DonaldB2003/CNC-Homework-Writing-Machine/3d-models/drawing-robot-arduino-uno-cnc-shield-grbl-model_files/y_back.stl

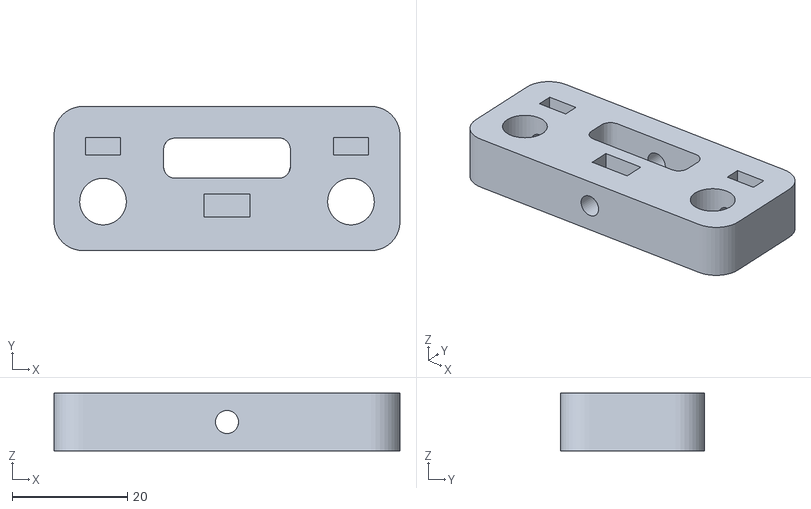
[picture p5: CAD file, 2026-09-09]
3d-models/drawing-robot-arduino-uno-cnc-shield-grbl-model_files/y_back.stl
60.0 x 25.0 x 10.0
