DonaldB2003/CNC-Homework-Writing-Machine/3d-models/drawing-robot-arduino-uno-cnc-shield-grbl-model_files/base_slide_heavy_duty_ha.stl

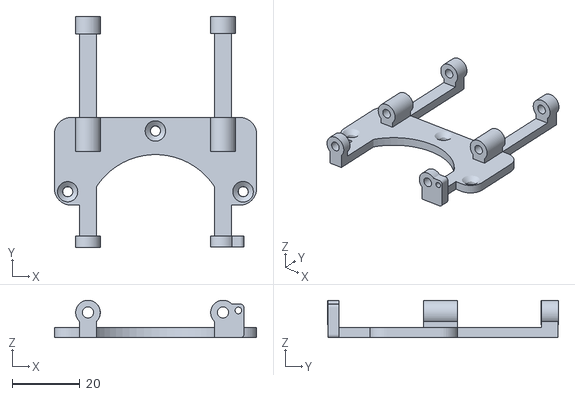
[picture p7: CAD file, 2026-09-09]
3d-models/drawing-robot-arduino-uno-cnc-shield-grbl-model_files/base_slide_heavy_duty_ha.stl
60.0 x 68.5 x 11.1
