DonaldB2003/CNC-Homework-Writing-Machine/3d-models/drawing-robot-arduino-uno-cnc-shield-grbl-model_files/uno_cnc_bottom.stl

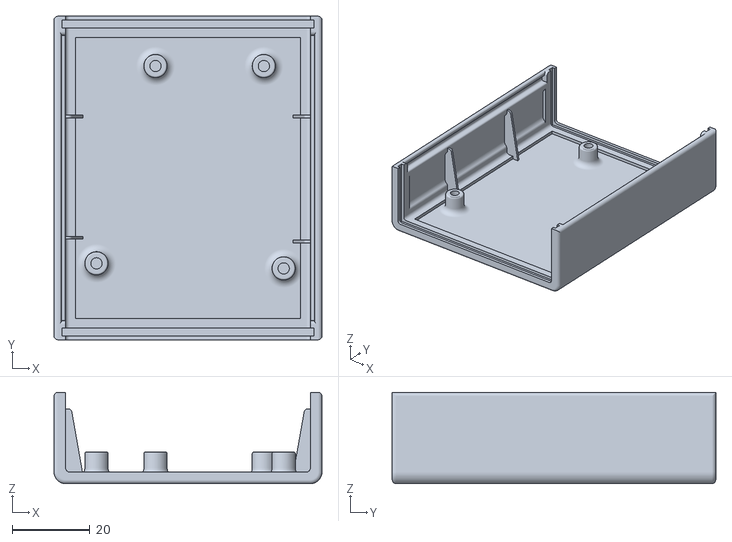
[picture p8: CAD file, 2026-09-09]
3d-models/drawing-robot-arduino-uno-cnc-shield-grbl-model_files/uno_cnc_bottom.stl
69.0 x 83.3 x 23.5
