DonaldB2003/CNC-Homework-Writing-Machine/3d-models/drawing-robot-arduino-uno-cnc-shield-grbl-model_files/cablestrainreliefanchorv2.stl

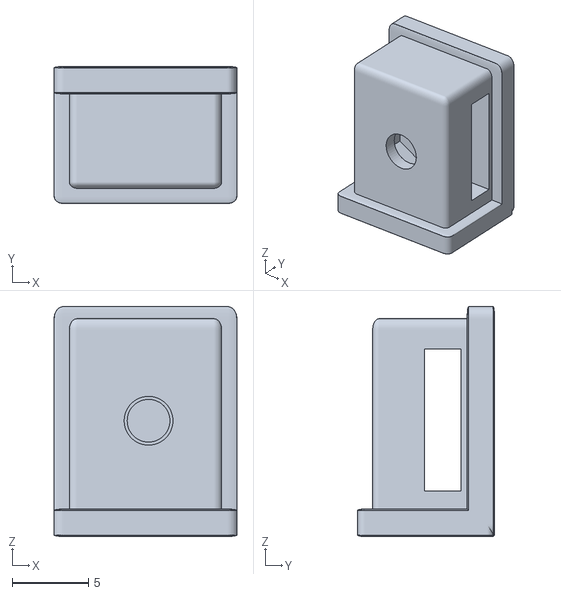
[picture p9: CAD file, 2026-09-09]
3d-models/drawing-robot-arduino-uno-cnc-shield-grbl-model_files/cablestrainreliefanchorv2.stl
12.0 x 9.00 x 15.1
