DonaldB2003/CNC-Homework-Writing-Machine/3d-models/drawing-robot-arduino-uno-cnc-shield-grbl-model_files/bottom_xy_clamshell_v2.stl

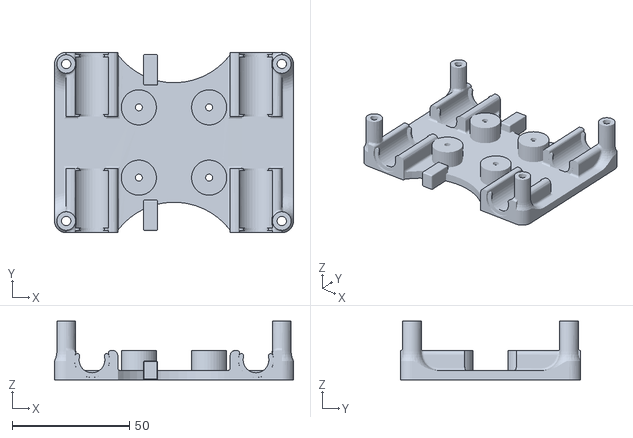
[picture p10: CAD file, 2026-09-09]
3d-models/drawing-robot-arduino-uno-cnc-shield-grbl-model_files/bottom_xy_clamshell_v2.stl
102.0 x 77.0 x 25.0
