DonaldB2003/CNC-Homework-Writing-Machine/3d-models/drawing-robot-arduino-uno-cnc-shield-grbl-model_files/top_xy_clamshell_v4.stl

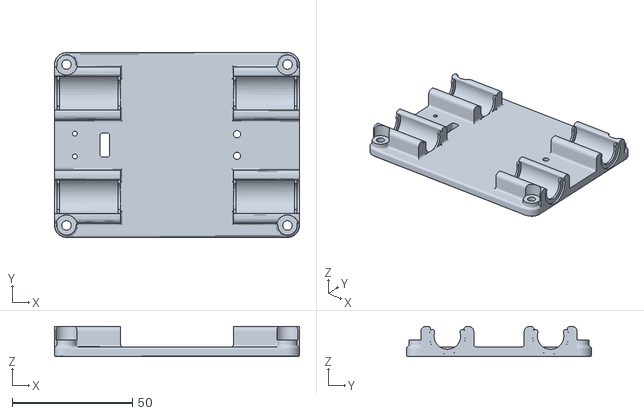
[picture p11: CAD file, 2026-09-09]
3d-models/drawing-robot-arduino-uno-cnc-shield-grbl-model_files/top_xy_clamshell_v4.stl
102.0 x 77.0 x 12.5
