DonaldB2003/CNC-Homework-Writing-Machine/3d-models/drawing-robot-arduino-uno-cnc-shield-grbl-model_files/drawbot_uno_enclosure_mount_base_v1.stl

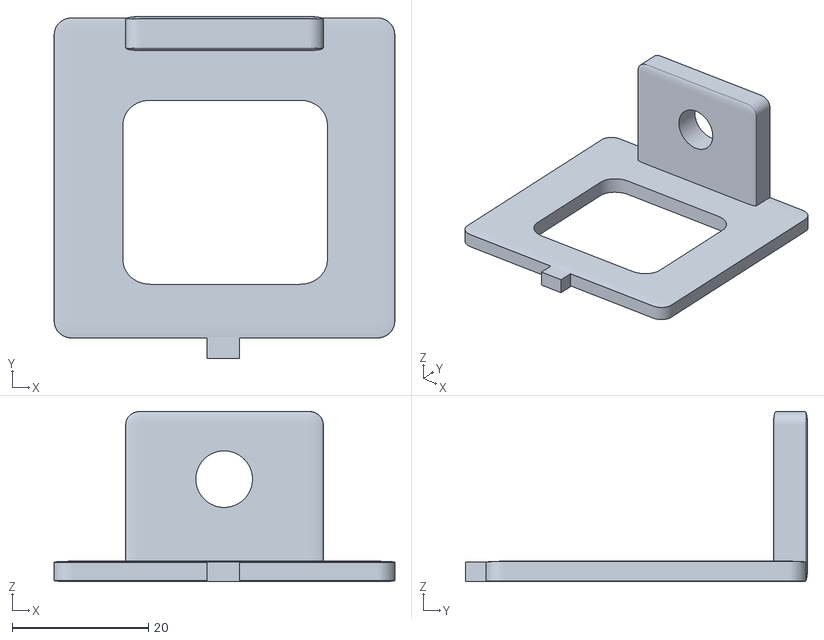
[picture p17: CAD file, 2026-09-09]
3d-models/drawing-robot-arduino-uno-cnc-shield-grbl-model_files/drawbot_uno_enclosure_mount_base_v1.stl
50.0 x 50.2 x 25.0
