DonaldB2003/CNC-Homework-Writing-Machine/3d-models/drawing-robot-arduino-uno-cnc-shield-grbl-model_files/base_slide_heavy_duty_v4.stl

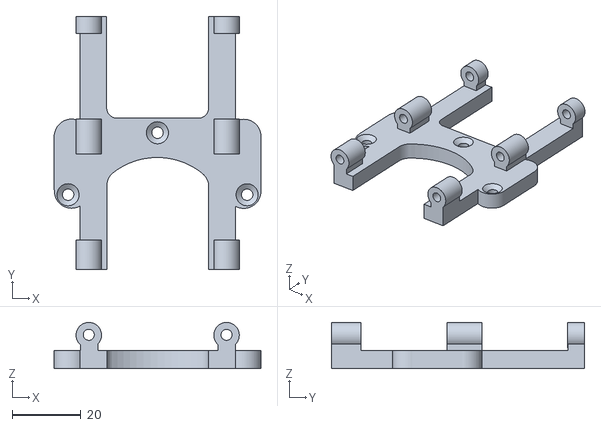
[picture p21: CAD file, 2026-09-09]
3d-models/drawing-robot-arduino-uno-cnc-shield-grbl-model_files/base_slide_heavy_duty_v4.stl
60.1 x 73.6 x 13.4
