DonaldB2003/CNC-Homework-Writing-Machine/3d-models/drawing-robot-arduino-uno-cnc-shield-grbl-model_files/slider_heavy_duty_v5.stl

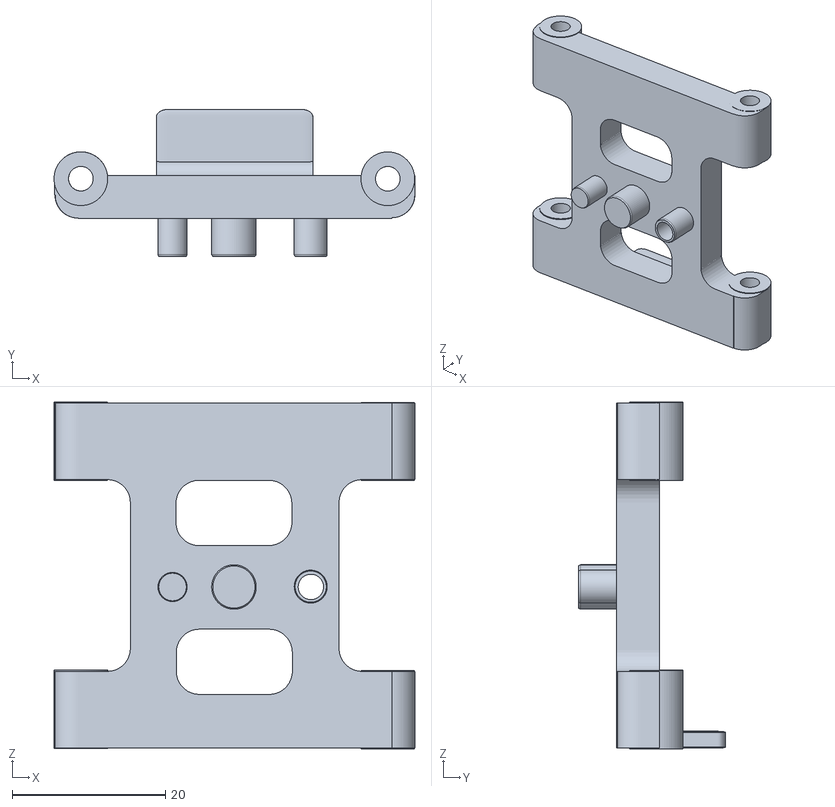
[picture p22: CAD file, 2026-09-09]
3d-models/drawing-robot-arduino-uno-cnc-shield-grbl-model_files/slider_heavy_duty_v5.stl
47.0 x 19.2 x 45.2
