DonaldB2003/CNC-Homework-Writing-Machine/(list of files, cad)

Other CAD files:
3d-models/drawing-robot-arduino-uno-cnc-shield-grbl-model_files/large_display_pen_holder_v2_137296.stl
3d-models/drawing-robot-arduino-uno-cnc-shield-grbl-model_files/x_support_l.stl
3d-models/drawing-robot-arduino-uno-cnc-shield-grbl-model_files/metric_3_mm_thumb_screw_v4.stl
